spmaxsp/diy-jbc/old_arduino_version/display-interface/README.md

# Code and Schematic for the Display Interface (running on a separate microcontroller)
