spmaxsp/diy-jbc/Hardware/PCB/Schematic_diy-jbc-stm32-logicboard_2024-06-14.pdf

+5V | +3.3V
GND | GND | GND

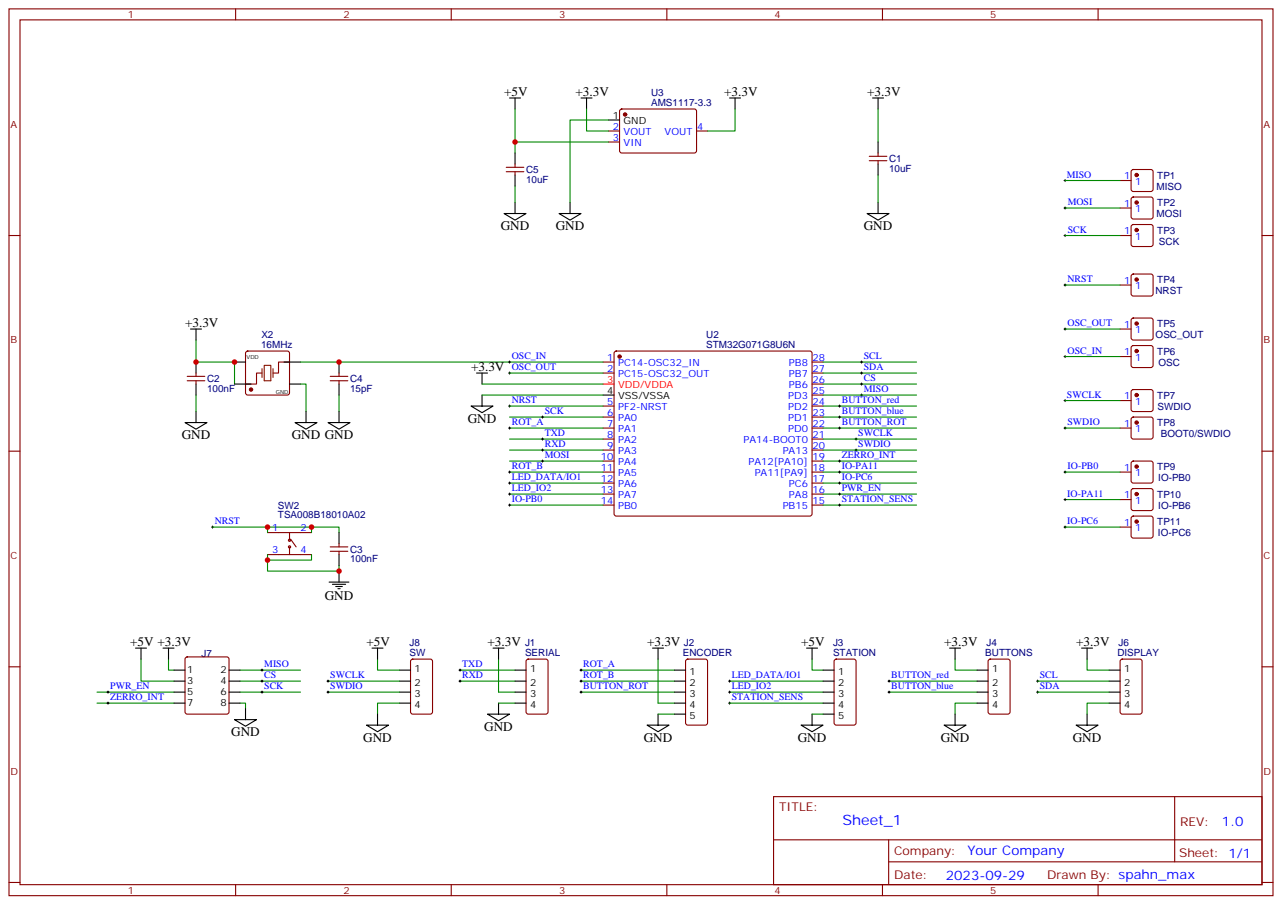
[picture p1: page 1]
