spmaxsp/diy-jbc/PCB/Schematic_diy-jbc_2023-03-16.pdf

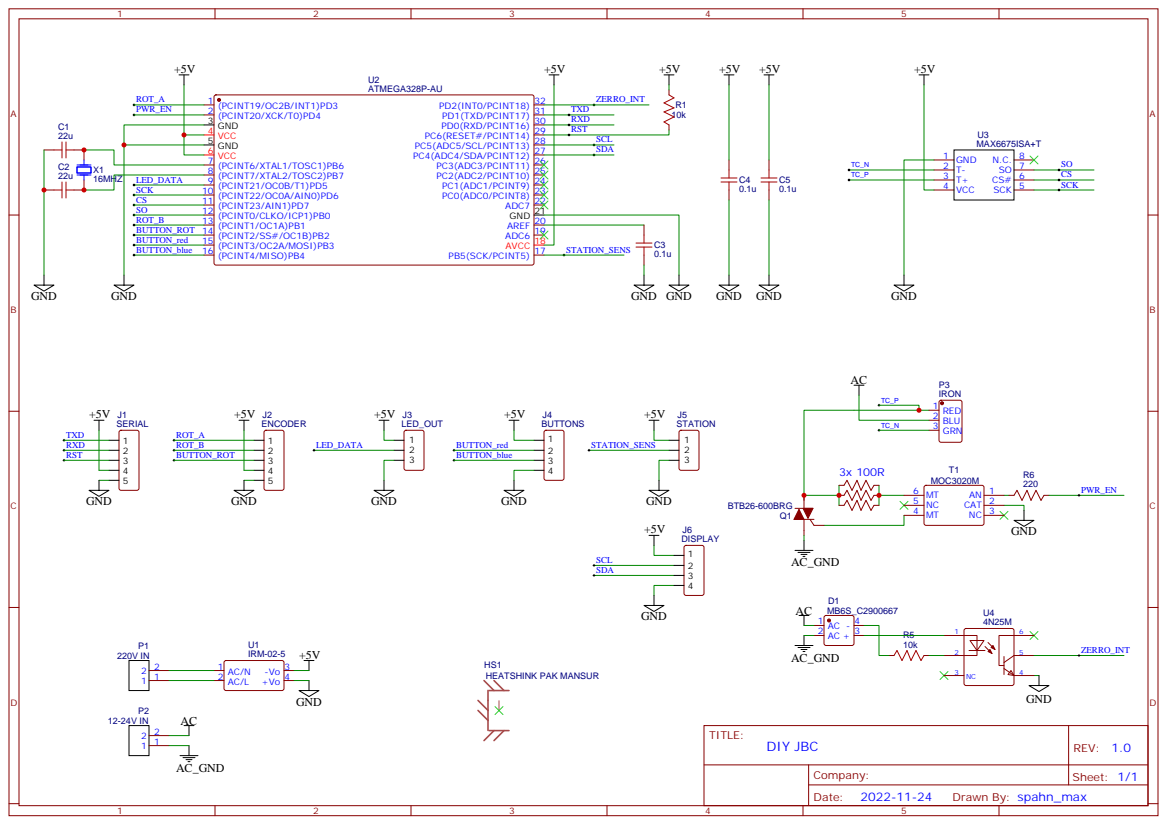
[picture p2: page 1]
