spmaxsp/diy-jbc/Hardware/PCB/Schematic_diy-jbc-stm32-power_2024-06-14.pdf

## IRM-10-5

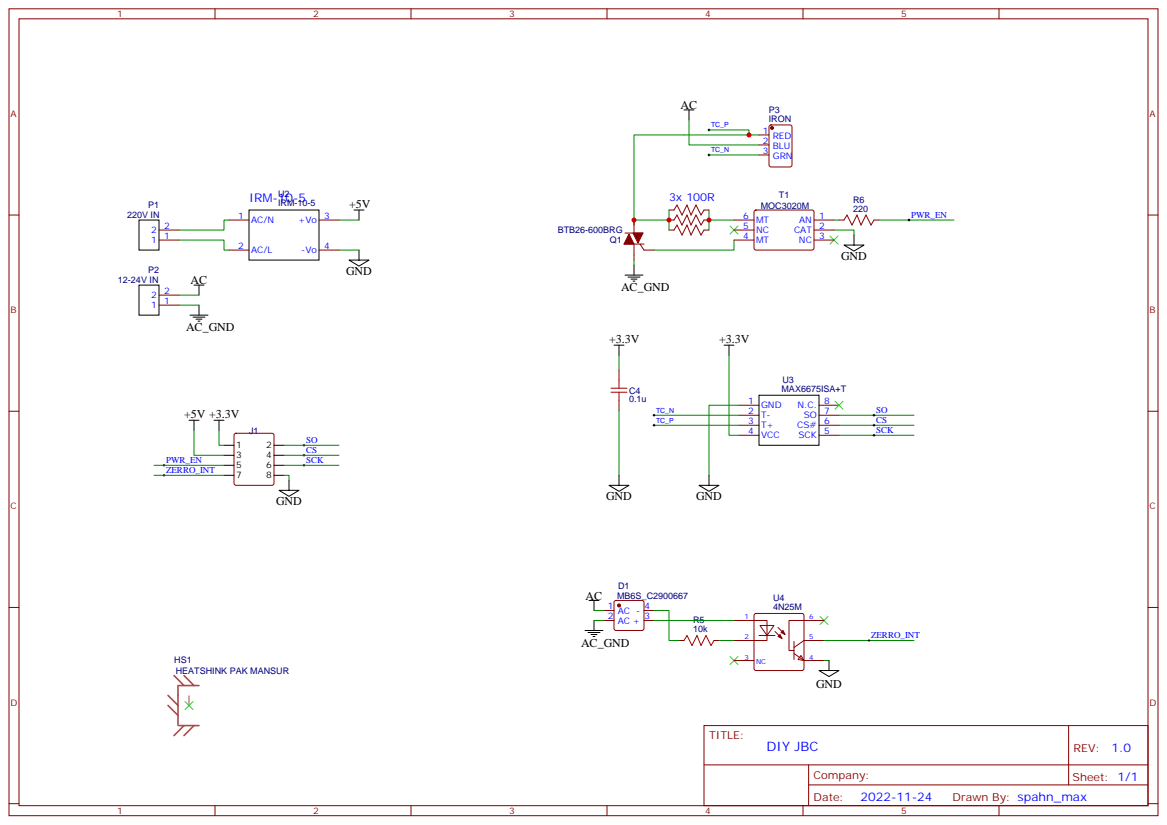
[picture p3: page 1]
