spmaxsp/diy-jbc/display-interface/PCB/Schematic_diy-jbc_display_2023-05-11.pdf

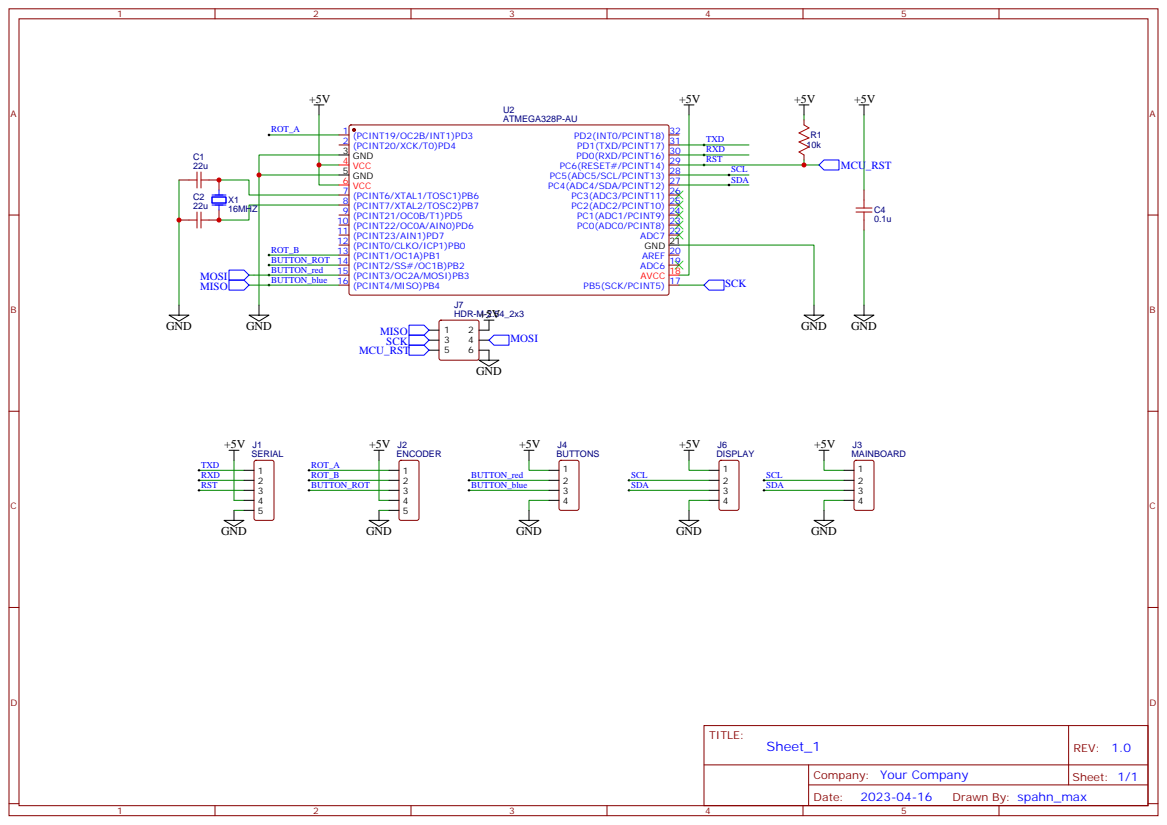
[picture p4: page 1]
