spmaxsp/diy-jbc/_cube-project/CubeProject.ioc

Mcu.UserName=STM32G071GBUxN
PA0.GPIO_Label=TEMP_SPI_SCK
PA0.Signal=SPI2_SCK
PA1.GPIO_Label=ENCODER_B
PA1.Signal=S_TIM2_CH2
PA13.Signal=SYS_SWDIO
PA14-BOOT0.Signal=SYS_SWCLK
PA2.GPIO_Label=SER_UI_TX
PA2.Signal=USART2_TX
PA3.GPIO_Label=SER_UI_RX
PA3.Signal=USART2_RX
PA4.Signal=SPI2_MOSI
PA5.GPIO_Label=ENCODER_A
PA5.Signal=S_TIM2_CH1_ETR
PA6.GPIO_Label=WS2812B
PA6.Signal=S_TIM3_CH1
PA8.GPIO_Label=PWR_TRIAC_EN
PA8.Signal=GPIO_Output
PB0.Signal=GPXTI0
PB15.GPIO_Label=STATION_SENS
PB15.Signal=GPIO_Input
PB6.GPIO_Label=TEMP_SPI_CS
PB6.Signal=GPIO_Output
PB7.GPIO_Label=DISP_I2C_SDA
PB7.Signal=I2C1_SDA
PB8.GPIO_Label=DISP_I2C_SCL
PB8.Signal=I2C1_SCL
PD0.GPIO_Label=BUTTON_ENCODER
PD0.Signal=GPIO_Input
PD1.GPIO_Label=BUTTON_BLUE
PD1.Signal=GPIO_Input
PD2.GPIO_Label=BUTTON_RED
PD2.Signal=GPIO_Input
PD3.GPIO_Label=TEMP_SPI_MISO
PD3.Signal=SPI2_MISO
