spmaxsp/diy-jbc/_cube-project/Core/Inc/main.h

#define TEMP_SPI_SCK_Pin LL_GPIO_PIN_0
#define TEMP_SPI_SCK_GPIO_Port GPIOA
#define ENCODER_B_Pin LL_GPIO_PIN_1
#define ENCODER_B_GPIO_Port GPIOA
#define SER_UI_TX_Pin LL_GPIO_PIN_2
#define SER_UI_TX_GPIO_Port GPIOA
#define SER_UI_RX_Pin LL_GPIO_PIN_3
#define SER_UI_RX_GPIO_Port GPIOA
#define ENCODER_A_Pin LL_GPIO_PIN_5
#define ENCODER_A_GPIO_Port GPIOA
#define WS2812B_Pin LL_GPIO_PIN_6
#define WS2812B_GPIO_Port GPIOA
#define STATION_SENS_Pin LL_GPIO_PIN_15
#define STATION_SENS_GPIO_Port GPIOB
#define PWR_TRIAC_EN_Pin LL_GPIO_PIN_8
#define PWR_TRIAC_EN_GPIO_Port GPIOA
#define BUTTON_ENCODER_Pin LL_GPIO_PIN_0
#define BUTTON_ENCODER_GPIO_Port GPIOD
#define BUTTON_BLUE_Pin LL_GPIO_PIN_1
#define BUTTON_BLUE_GPIO_Port GPIOD
#define BUTTON_RED_Pin LL_GPIO_PIN_2
#define BUTTON_RED_GPIO_Port GPIOD
#define TEMP_SPI_MISO_Pin LL_GPIO_PIN_3
#define TEMP_SPI_MISO_GPIO_Port GPIOD
#define TEMP_SPI_CS_Pin LL_GPIO_PIN_6
#define TEMP_SPI_CS_GPIO_Port GPIOB
#define DISP_I2C_SDA_Pin LL_GPIO_PIN_7
#define DISP_I2C_SDA_GPIO_Port GPIOB
#define DISP_I2C_SCL_Pin LL_GPIO_PIN_8
#define DISP_I2C_SCL_GPIO_Port GPIOB
