spmaxsp/diy-jbc/Core/Hardware/Inc/tim_encoder.h

/**
  ******************************************************************************
  * @file    tim_encoder.h
  * @brief   
  ******************************************************************************
  */

/* Define to prevent recursive inclusion -------------------------------------*/
#ifndef __TIM_ENCODER_H__
#define __TIM_ENCODER_H__

#ifdef __cplusplus
extern "C" {
#endif

/* Includes ------------------------------------------------------------------*/

#include "stm32g0xx_ll_i2c.h"
#include "stm32g0xx_ll_rcc.h"
#include "stm32g0xx_ll_bus.h"
#include "stm32g0xx_ll_system.h"
#include "stm32g0xx_ll_exti.h"
#include "stm32g0xx_ll_cortex.h"
#include "stm32g0xx_ll_utils.h"
#include "stm32g0xx_ll_pwr.h"
#include "stm32g0xx_ll_dma.h"
#include "stm32g0xx_ll_spi.h"
#include "stm32g0xx_ll_tim.h"
#include "stm32g0xx_ll_usart.h"
#include "stm32g0xx_ll_gpio.h"

#include "hw_define.h"

/* Exported types ------------------------------------------------------------*/

void TIM_Encoder__Init(void);
void TIM_Encoder__Enable(void);

#ifdef __cplusplus
}
#endif

#endif /* __TIM_ENCODER_H__ */
