spmaxsp/diy-jbc/display-interface/diy-jbc-display/src/display/screenmanager.h

#ifndef SCREENMANAGER_H_
#define SCREENMANAGER_H_

#include "input.h"
#include "screen.h"

class ScreenManager {
    private:
        Screen* active_screen;
        Screen* screens[3];
        int screen_count = 0;
    public:
        ScreenManager();
        void display();
        void handle_input(Input* input);
        void add_screen(Screen* screen);
        void set_active_screen(int screen_id);
};

#endif /* SCREENMANAGER_H_ */
