spmaxsp/diy-jbc/(commit log)

2022-11-22 removing timers
2022-11-24 fixing some smaller errors
    [temperature.h]
2022-11-28 adding ws2812 status heatmap
2022-11-28 moving pin definitions to corresponding header
2022-12-01 adding real temperature correction function
    [temperature.h]
2022-12-01 adding functionality to serial cammand: set_eeprom print_settings
2022-12-11 adding design prototype for oled
2022-12-12 adding a prototype for temperature graph
2022-12-17 moving all display components to different files and improving/fixing the constructor (also renaming some stuff)
    [display.cpp, display.h, menue.cpp]
2023-03-11 moving code to seperate folders (while trying to keep compatibility with arduino ide)
2023-03-11 changing pid libary
2023-03-16 Upload PCB
2023-03-17 fixing error (input has to be a pointer)
    [screenmanager.cpp, screenmanager.h]
2023-03-18 adding button logic to menue
2023-03-18 adding pin definitions and moving all other to main
2023-03-18 fixing some smaller issues
    [input.h, menue.cpp, menue.h, screenmanager.h]
2023-03-23 avoiding definitions in header files
    [input.cpp, input.h, menue.cpp, menue.h, screenmanager.h]
2023-03-24 adding button logic to screenmanager
2023-03-24 updating button logic on menue
2023-05-12 uploading display pcb
2023-05-12 temporary uncommenting status-led
2024-06-14 move old arduino version in subfolder
2024-08-25 uploading gerber stm version
2024-08-25 uploading gerber for frontplate
2024-08-25 updating STM32Cube project
2024-09-09 updating STM32Cube project II
2024-10-01 adding hardware component for buttons
2024-10-01 adding hardware component for i2c
2024-10-01 adding hardware component for spi
2024-10-01 implementing temperature sensor
2024-10-02 adding ll lib drivers
2024-10-02 implementing pid algorithm
2024-10-02 adding hardware components for encoder
2024-10-03 implementing encoder
2024-10-10 implementing power control using zc-interrupt
2024-10-10 improving pid value updates
2024-10-10 adding new functions to main and fix mainloop
    [main.c, main.h]
2024-10-10 fixing white lines in display
    [display.c]
2024-10-10 fixing encoder and adding relative movement
    [encoder.c]
2024-10-10 updating encoder header
